Styann/Anesidora/pcb/Anesidora/Anesidora.kicad_pcb

## KiCad design pcb/Anesidora/Anesidora.kicad_pcb (2025-02-02)

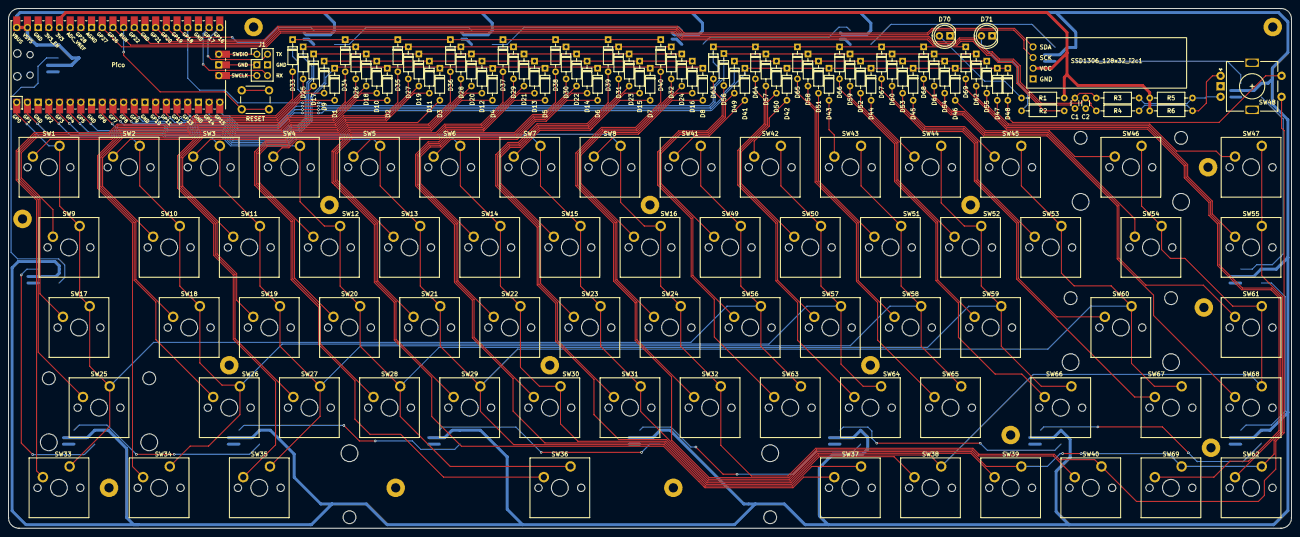
[picture p1: board Anesidora.kicad_pcb from above]

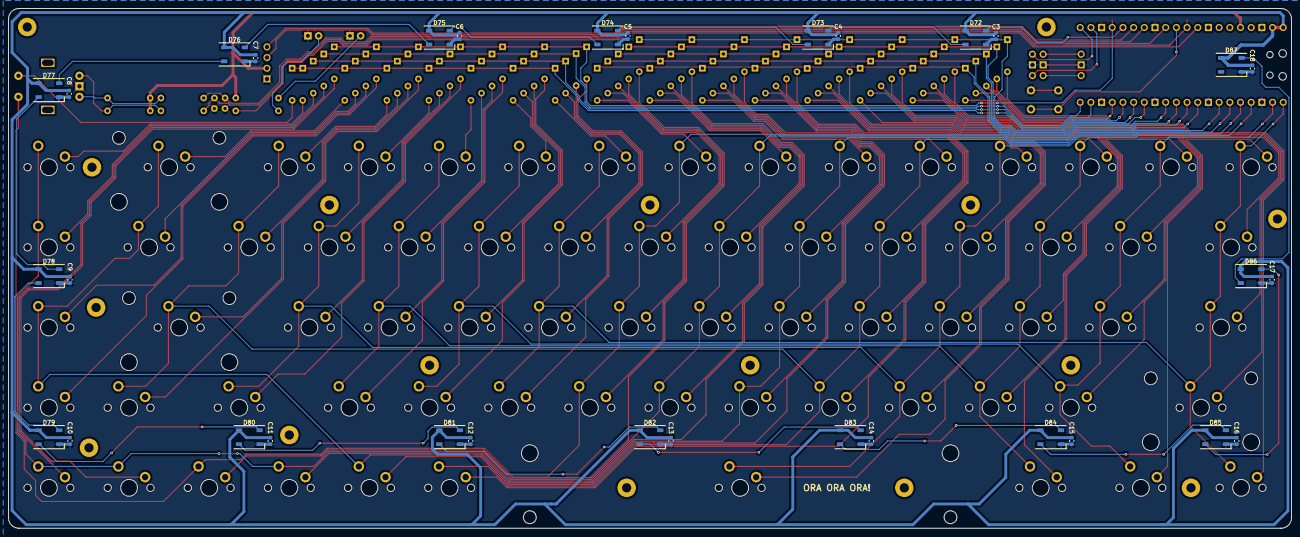
[picture p2: board Anesidora.kicad_pcb from below]

Board: 2 copper layers, 305.0 x 123.5 mm, 200 parts (32 on the bottom side), 119 nets.

Parts:
C1, C2: 0.01 µf; C_Disc_D3.0mm_W1.6mm_P2.50mm
C3, C4, C5, C6, C7, C8, C9, C10, C11, C12, C13, C14, C15, C16, C17, C18: 100nF; C_0603_1608Metric
D1, D2, D3, D4, D5, D6, D7, D8, D9, D10, D11, D12, D13, D14, D15, D16, D17, D18, D19, D20, D21, D22, D23, D24, D25, D26, D27, D28, D29, D30, D31, D32, D33, D34, D35, D36, D37, D38, D39, D40, D41, D42, D43, D44, D45, D46, D47, D48, D49, D50, D51, D52, D53, D54, D55, D56, D57, D58, D59, D60, D61, D62, D63, D64, D65, D66, D67, D68, D69: 1N4148; D_DO-35_SOD27_P7.62mm_Horizontal
D70, D71: LED; LED_D5.0mm
D72, D73, D74, D75, D76, D77, D78, D79, D80, D81, D82, D83, D84, D85, D86, D87: WS2812B; LED_WS2812B_PLCC4_5.0x5.0mm_P3.2mm
H1, H2, H3, H4, H5, H6, H7, H8, H9, H10, H11, H12, H13, H14, H15, H16: MountingHole; MountingHole_2.2mm_M2_Pad
J1: Conn_01x06_Socket; PinHeader_2x03_P2.54mm_Vertical
Pico: Pico; RPi_Pico_SMD_TH
R1, R2: 390; R_Axial_DIN0207_L6.3mm_D2.5mm_P10.16mm_Horizontal
R3, R4, R5, R6: 10k; R_Axial_DIN0207_L6.3mm_D2.5mm_P10.16mm_Horizontal
RESET: SW_Push; SW_PUSH_6mm
SSD1306_128x32_i2c1: SSD1306_128x32_i2c
SW1, SW2, SW3, SW4, SW5, SW6, SW7, SW8, SW10, SW11, SW12, SW13, SW14, SW15, SW16, SW18, SW19, SW20, SW21, SW22, SW23, SW24, SW26, SW27, SW28, SW29, SW30, SW31, SW32, SW37, SW38, SW39, SW40, SW41, SW42, SW43, SW44, SW45, SW47, SW49, SW50, SW51, SW52, SW53, SW55, SW56, SW57, SW58, SW59, SW61, SW62, SW63, SW64, SW65, SW67, SW68, SW69: SW_Push_45deg; SW_Cherry_MX_PCB_1.00u
SW9, SW54: SW_Push_45deg; SW_Cherry_MX_PCB_1.50u
SW17, SW66: SW_Push_45deg; SW_Cherry_MX_PCB_1.75u
SW25, SW60: SW_Push_45deg; SW_Cherry_MX_PCB_2.25u
SW33, SW34, SW35: SW_Push_45deg; SW_Cherry_MX_PCB_1.25u
SW36: SW_Push_45deg; SW_Cherry_MX_PCB_6.25u
SW46: SW_Push_45deg; SW_Cherry_MX_PCB_2.00u
SW48: RotaryEncoder_Switch; RotaryEncoder_Alps_EC11E-Switch_Vertical_H20mm

Connections:
+3V3: Pico.36 (3V3), R1.1, R5.1, R6.1, SSD1306_128x32_i2c1.2 (VCC)
+5V: C3.2, C4.2, C5.2, C6.2, C7.2, C8.2, C9.2, C10.2, C11.2, C12.2, C13.2, C14.2, C15.2, C16.2, C17.2, C18.2, D72.1 (VDD), D73.1 (VDD), D74.1 (VDD), D75.1 (VDD), D76.1 (VDD), D77.1 (VDD), D78.1 (VDD), D79.1 (VDD), D80.1 (VDD), D81.1 (VDD), D82.1 (VDD), D83.1 (VDD), D84.1 (VDD), D85.1 (VDD), D86.1 (VDD), D87.1 (VDD), Pico.39 (VSYS), Pico.40 (VBUS)
Col 1: Pico.1 (GPIO0), SW1.2, SW9.2, SW17.2, SW25.2, SW33.2, SW41.2, SW49.2, SW56.2, SW63.2
Col 2: Pico.2 (GPIO1), SW2.2, SW10.2, SW18.2, SW26.2, SW34.2, SW42.2, SW50.2, SW57.2, SW64.2
Col 3: Pico.4 (GPIO2), SW3.2, SW11.2, SW19.2, SW27.2, SW35.2, SW43.2, SW51.2, SW58.2, SW65.2
Col 4: Pico.5 (GPIO3), SW4.2, SW12.2, SW20.2, SW28.2, SW36.2, SW44.2, SW52.2, SW59.2, SW66.2
Col 5: Pico.6 (GPIO4), SW5.2, SW13.2, SW21.2, SW29.2, SW37.2, SW45.2, SW53.2, SW60.2, SW67.2
Col 6: Pico.7 (GPIO5), SW6.2, SW14.2, SW22.2, SW30.2, SW38.2, SW46.2, SW54.2, SW61.2, SW68.2
Col 7: Pico.9 (GPIO6), SW7.2, SW15.2, SW23.2, SW31.2, SW39.2, SW47.2, SW55.2, SW62.2, SW69.2
Col 8: Pico.10 (GPIO7), SW8.2, SW16.2, SW24.2, SW32.2, SW40.2, SW48.S1
GND: C1.2, C2.2, C3.1, C4.1, C5.1, C6.1, C7.1, C8.1, C9.1, C10.1, C11.1, C12.1, C13.1, C14.1, C15.1, C16.1, C17.1, C18.1, D70.1 (K), D71.1 (K), D72.3 (VSS), D73.3 (VSS), D74.3 (VSS), D75.3 (VSS), D76.3 (VSS), D77.3 (VSS), D78.3 (VSS), D79.3 (VSS), D80.3 (VSS), D81.3 (VSS), D82.3 (VSS), D83.3 (VSS), D84.3 (VSS), D85.3 (VSS), D86.3 (VSS), D87.3 (VSS), J1.3, J1.4, Pico.3 (GND), Pico.8 (GND), Pico.13 (GND), Pico.18 (GND), Pico.23 (GND), Pico.28 (GND), Pico.38 (GND), Pico.42 (GND), RESET.2, SSD1306_128x32_i2c1.1 (GND), SW48.C
unnamed: D1.2 (A), SW1.1
unnamed: D2.2 (A), SW2.1
unnamed: D3.2 (A), SW3.1
unnamed: D4.2 (A), SW4.1
unnamed: D5.2 (A), SW5.1
unnamed: D6.2 (A), SW6.1
unnamed: D7.2 (A), SW7.1
unnamed: D8.2 (A), SW8.1
unnamed: D9.2 (A), SW9.1
unnamed: D10.2 (A), SW10.1
unnamed: D11.2 (A), SW11.1
unnamed: D12.2 (A), SW12.1
unnamed: D13.2 (A), SW13.1
unnamed: D14.2 (A), SW14.1
unnamed: D15.2 (A), SW15.1
unnamed: D16.2 (A), SW16.1
unnamed: D17.2 (A), SW17.1
unnamed: D18.2 (A), SW18.1
unnamed: D19.2 (A), SW19.1
unnamed: D20.2 (A), SW20.1
unnamed: D21.2 (A), SW21.1
unnamed: D22.2 (A), SW22.1
unnamed: D23.2 (A), SW23.1
unnamed: D24.2 (A), SW24.1
unnamed: D25.2 (A), SW25.1
unnamed: D26.2 (A), SW26.1
unnamed: D27.2 (A), SW27.1
unnamed: D28.2 (A), SW28.1
unnamed: D29.2 (A), SW29.1
unnamed: D30.2 (A), SW30.1
unnamed: D31.2 (A), SW31.1
unnamed: D32.2 (A), SW32.1
unnamed: D33.2 (A), SW33.1
unnamed: D34.2 (A), SW34.1
unnamed: D35.2 (A), SW35.1
unnamed: D36.2 (A), SW36.1
unnamed: D37.2 (A), SW37.1
unnamed: D38.2 (A), SW38.1
unnamed: D39.2 (A), SW39.1
unnamed: D40.2 (A), SW40.1
unnamed: D41.2 (A), SW41.1
unnamed: D42.2 (A), SW42.1
unnamed: D43.2 (A), SW43.1
unnamed: D44.2 (A), SW44.1
unnamed: D45.2 (A), SW45.1
unnamed: D46.2 (A), SW46.1
unnamed: D47.2 (A), SW47.1
unnamed: D48.2 (A), SW48.S2
unnamed: D49.2 (A), SW49.1
unnamed: D50.2 (A), SW50.1
unnamed: D51.2 (A), SW51.1
unnamed: D52.2 (A), SW52.1
unnamed: D53.2 (A), SW53.1
unnamed: D54.2 (A), SW54.1
unnamed: D55.2 (A), SW55.1
unnamed: D56.2 (A), SW56.1
unnamed: D57.2 (A), SW57.1
unnamed: D58.2 (A), SW58.1
unnamed: D59.2 (A), SW59.1
unnamed: D60.2 (A), SW60.1
unnamed: D61.2 (A), SW61.1
unnamed: D62.2 (A), SW62.1
unnamed: D63.2 (A), SW63.1
unnamed: D64.2 (A), SW64.1
unnamed: D65.2 (A), SW65.1
unnamed: D66.2 (A), SW66.1
unnamed: D67.2 (A), SW67.1
unnamed: D68.2 (A), SW68.1
unnamed: D69.2 (A), SW69.1
unnamed: D70.2 (A), R1.2
unnamed: D71.2 (A), R2.2
unnamed: D72.2 (DOUT), D73.4 (DIN)
unnamed: D73.2 (DOUT), D74.4 (DIN)
unnamed: D74.2 (DOUT), D75.4 (DIN)
unnamed: D75.2 (DOUT), D76.4 (DIN)
unnamed: D76.2 (DOUT), D77.4 (DIN)
unnamed: D77.2 (DOUT), D78.4 (DIN)
unnamed: D78.2 (DOUT), D79.4 (DIN)
unnamed: D79.2 (DOUT), D80.4 (DIN)
unnamed: D80.2 (DOUT), D81.4 (DIN)
unnamed: D81.2 (DOUT), D82.4 (DIN)
unnamed: D82.2 (DOUT), D83.4 (DIN)
unnamed: D83.2 (DOUT), D84.4 (DIN)
unnamed: D84.2 (DOUT), D85.4 (DIN)
unnamed: D85.2 (DOUT), D86.4 (DIN)
unnamed: D86.2 (DOUT), D87.4 (DIN)
unnamed: R3.2, R5.2, SW48.B
unnamed: R4.2, R6.2, SW48.A
unnamed: Pico.27 (GPIO21), SSD1306_128x32_i2c1.3 (SCK)
unnamed: Pico.26 (GPIO20), SSD1306_128x32_i2c1.4 (SDA)
unnamed: Pico.32 (GPIO27_ADC1), R2.1
unnamed: Pico.30 (RUN), RESET.1
Rot CLK: C2.1, Pico.31 (GPIO26_ADC0), R4.1
Rot DT: C1.1, Pico.29 (GPIO22), R3.1
Row 1: D1.1 (K), D2.1 (K), D3.1 (K), D4.1 (K), D5.1 (K), D6.1 (K), D7.1 (K), D8.1 (K), Pico.11 (GPIO8)
Row 2: D9.1 (K), D10.1 (K), D11.1 (K), D12.1 (K), D13.1 (K), D14.1 (K), D15.1 (K), D16.1 (K), Pico.12 (GPIO9)
Row 3: D17.1 (K), D18.1 (K), D19.1 (K), D20.1 (K), D21.1 (K), D22.1 (K), D23.1 (K), D24.1 (K), Pico.14 (GPIO10)
Row 4: D25.1 (K), D26.1 (K), D27.1 (K), D28.1 (K), D29.1 (K), D30.1 (K), D31.1 (K), D32.1 (K), Pico.15 (GPIO11)
Row 5: D33.1 (K), D34.1 (K), D35.1 (K), D36.1 (K), D37.1 (K), D38.1 (K), D39.1 (K), D40.1 (K), Pico.16 (GPIO12)
Row 6: D41.1 (K), D42.1 (K), D43.1 (K), D44.1 (K), D45.1 (K), D46.1 (K), D47.1 (K), D48.1 (K), Pico.17 (GPIO13)
Row 7: D49.1 (K), D50.1 (K), D51.1 (K), D52.1 (K), D53.1 (K), D54.1 (K), D55.1 (K), Pico.19 (GPIO14)
Row 8: D56.1 (K), D57.1 (K), D58.1 (K), D59.1 (K), D60.1 (K), D61.1 (K), D62.1 (K), Pico.20 (GPIO15)
Row 9: D63.1 (K), D64.1 (K), D65.1 (K), D66.1 (K), D67.1 (K), D68.1 (K), D69.1 (K), Pico.24 (GPIO18)
leds: D72.4 (DIN), Pico.25 (GPIO19)
swclk: J1.5, Pico.41 (SWCLK)
swdio: J1.1, Pico.43 (SWDIO)
uart rx: J1.6, Pico.22 (GPIO17)
uart tx: J1.2, Pico.21 (GPIO16)
