Styann/Anesidora/(commit log)

2025-02-02 final pcb production
    [Anesidora.kicad_pcb]
2025-02-12 + comment led page in report descriptor, optimize key matrix scan, ack any unhandled usb request, constantize many things, fix string descriptor odd length
    [anesidora.c]
2025-04-05 add game mode that replace gui left key with alt right key, fn keys on numbers,
    [anesidora.c]
2026-06-17 caps lock feature, remove useless prototype from keyboard.h, fix switch case break
    [anesidora.c]
2026-06-18 replace ALT_RIGHT with F13 (game mode)
    [anesidora.c]
